propane-and-electrons/bcard-rgbdmx/docs/bcard-rgbdmx-schematic.pdf

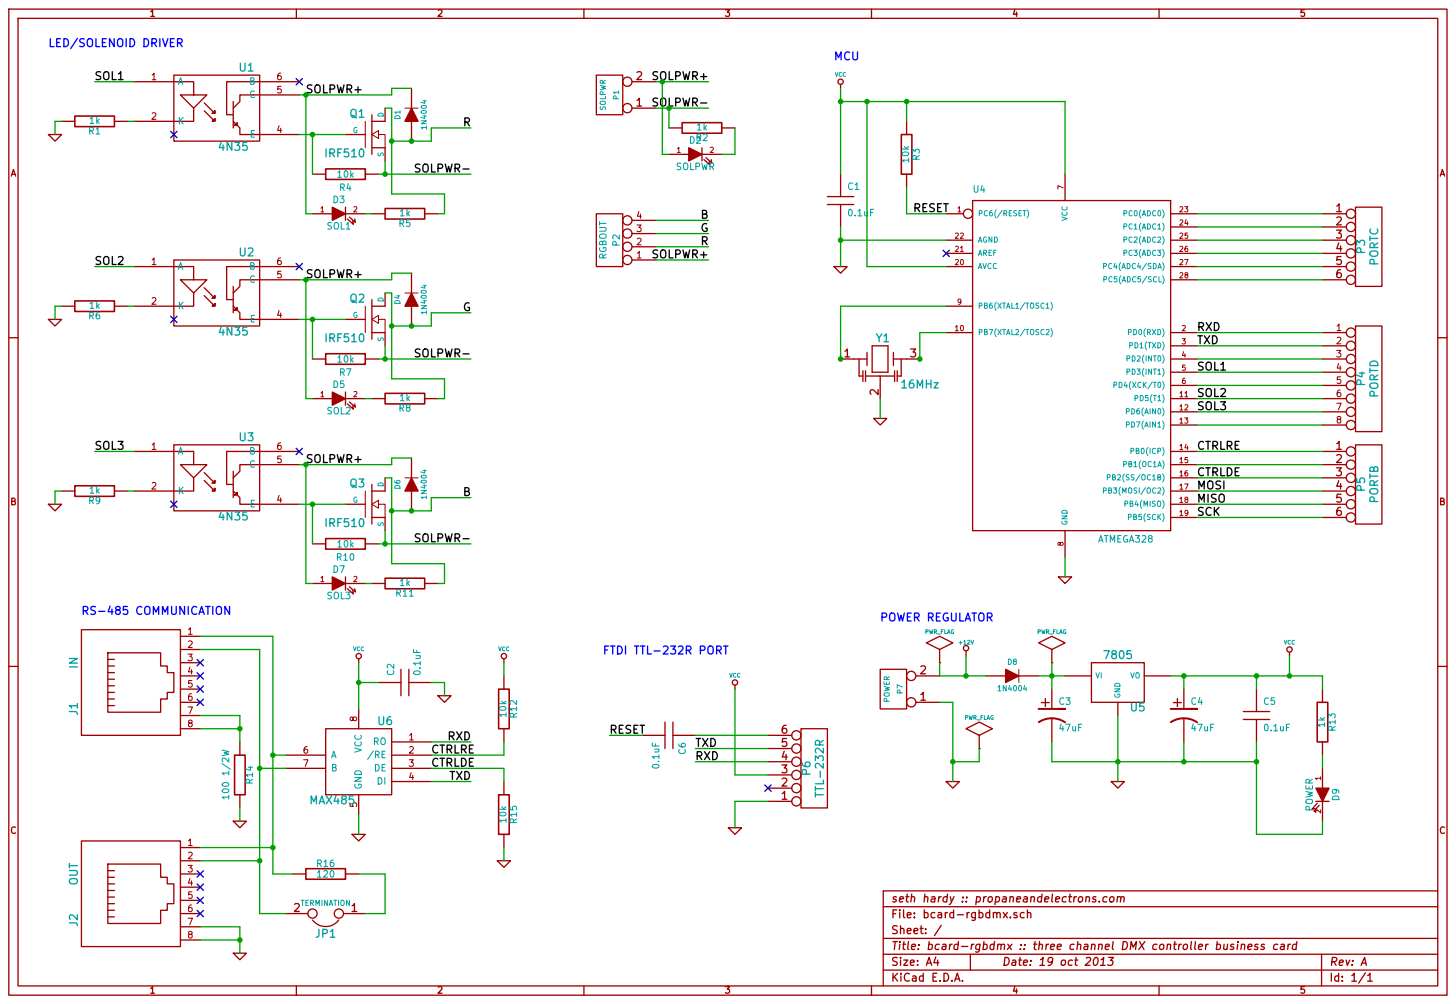
[picture p2: page 1]

seth hardy :: propaneandelectrons.com
File: bcard-rgbdmx.sch
Sheet: /
Title: bcard-rgbdmx :: three channel DMX controller business card
