propane-and-electrons/bcard-rgbdmx/hardware/bcard-rgbdmx.sch

## KiCad design hardware/bcard-rgbdmx.sch (2013-10-19)

Schematic: bcard-rgbdmx.sch

Parts:
C1, C2, C5, C6: 0.1uF; C2
C3, C4: 47uF; C1V5
D1, D4, D6, D8: 1N4004; D3
D2: SOLPWR; LED-3MM
D3: SOL1; LED-3MM
D5: SOL2; LED-3MM
D7: SOL3; LED-3MM
D9: POWER; LED-3MM
J1: IN; RJ45_8
J2: OUT; RJ45_8
JP1: TERMINATION; SIL-2
P1: SOLPWR; 5MMSCREWTERM
P2: RGBOUT; SIL-4
P3: PORTC; SIL-6
P4: PORTD; SIL-8
P5: PORTB; SIL-6
P6: TTL-232R; SIL-6
P7: POWER; 5MMSCREWTERM
Q1, Q2, Q3: IRF510; TO220GDS_VERT
R1, R2, R5, R6, R8, R9, R11, R13: 1k; R3
R3, R4, R7, R10, R12, R15: 10k; R3
R14: 100 1/2W; R3-5
R16: 120; R3
U1, U2, U3: 4N35; DIP-6__300
U4: ATMEGA328; DIP-28__300
U5: 7805
U6: MAX485; DIP-8__300
Y1: 16MHz; SIL-3

Notes on the sheet:
RS-485 COMMUNICATION
POWER REGULATOR
FTDI TTL-232R PORT
MCU
LED/SOLENOID DRIVER
