propane-and-electrons/bcard-rgbdmx/(commit log)

2013-10-19 new business card\!
    [bcard-rgbdmx.brd, bcard-rgbdmx.sch]
2013-10-21 just a few slight silk changes...
    [bcard-rgbdmx.brd]
2014-01-05 adding documentation
    [bcard-rgbdmx-BOM.csv]
2014-01-05 minor edit to BOM
    [bcard-rgbdmx-BOM.csv]
2014-01-06 minor fixes: space around power connectors, jacks lining up, silk changes
    [bcard-rgbdmx.brd]
